sefisher/6DOF-servo/img/assetto_corsa.png

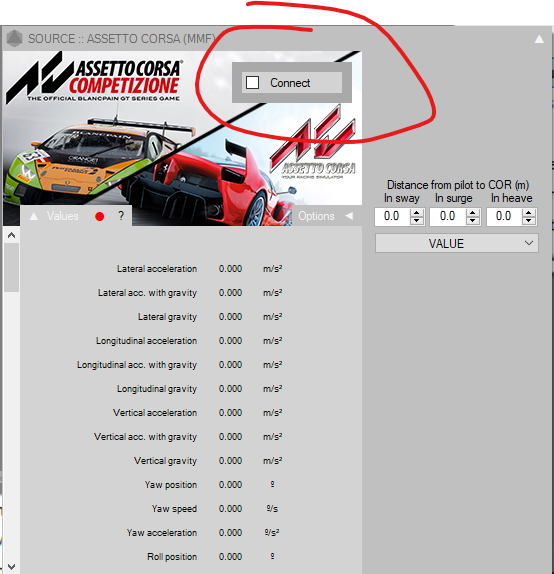
img/assetto_corsa.png
