sefisher/6DOF-servo/img/runtest-connect-source.png

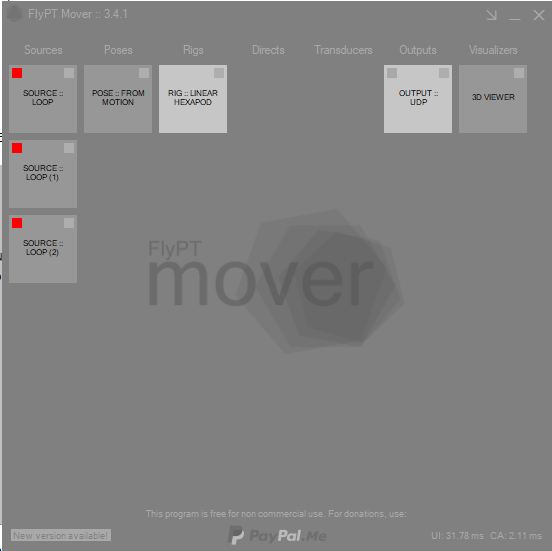
img/runtest-connect-source.png
