sefisher/6DOF-servo/other files/thingiverse desktop model stl/Actuator-Base.STL

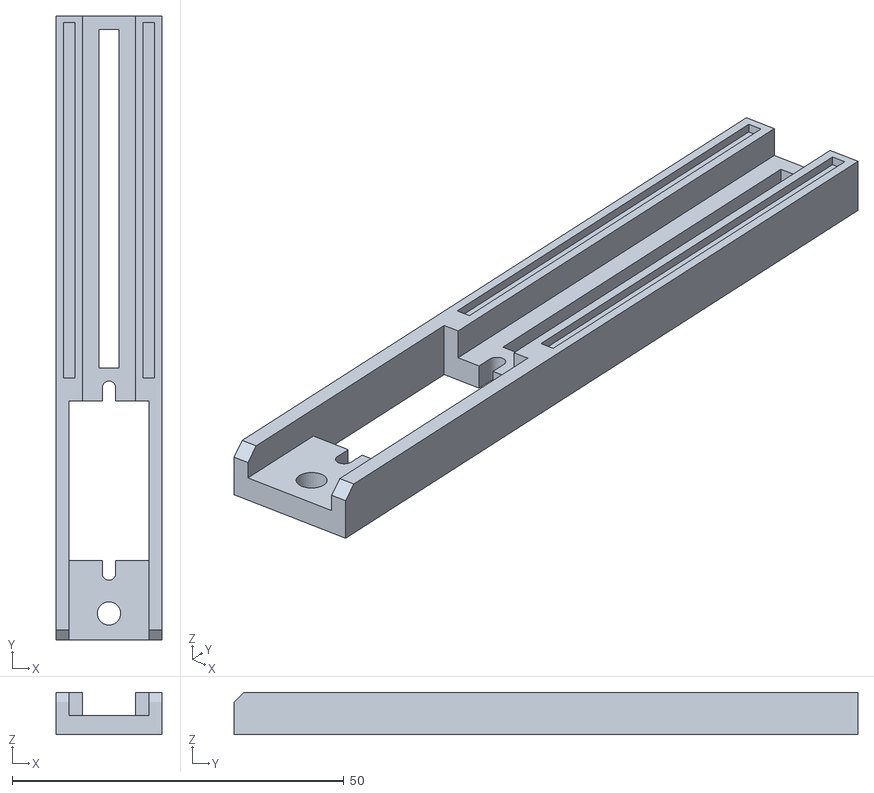
[picture p18: CAD file, 2021-08-05]
other files/thingiverse desktop model stl/Actuator-Base.STL
16.0 x 94.0 x 6.40
