sefisher/6DOF-servo/other files/thingiverse desktop model stl/Actuator-Rod.STL

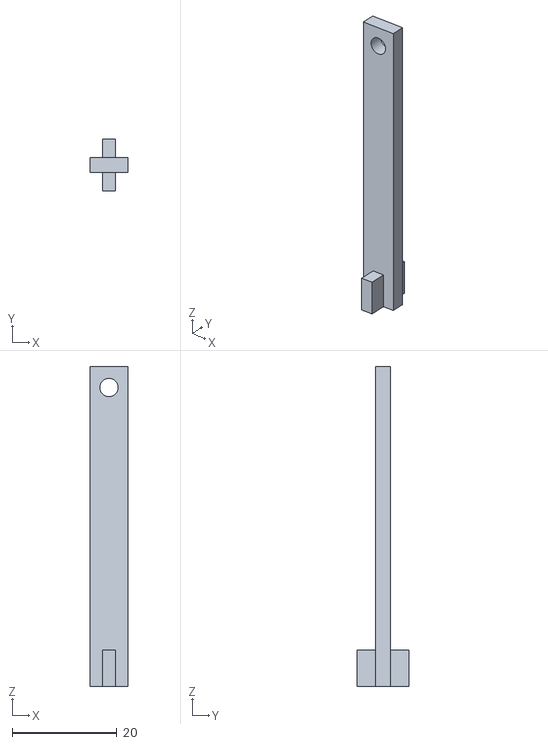
[picture p19: CAD file, 2021-08-05]
other files/thingiverse desktop model stl/Actuator-Rod.STL
7.25 x 10.0 x 61.0
