sefisher/6DOF-servo/other files/thingiverse desktop model stl/Actuator-Joint_F.STL

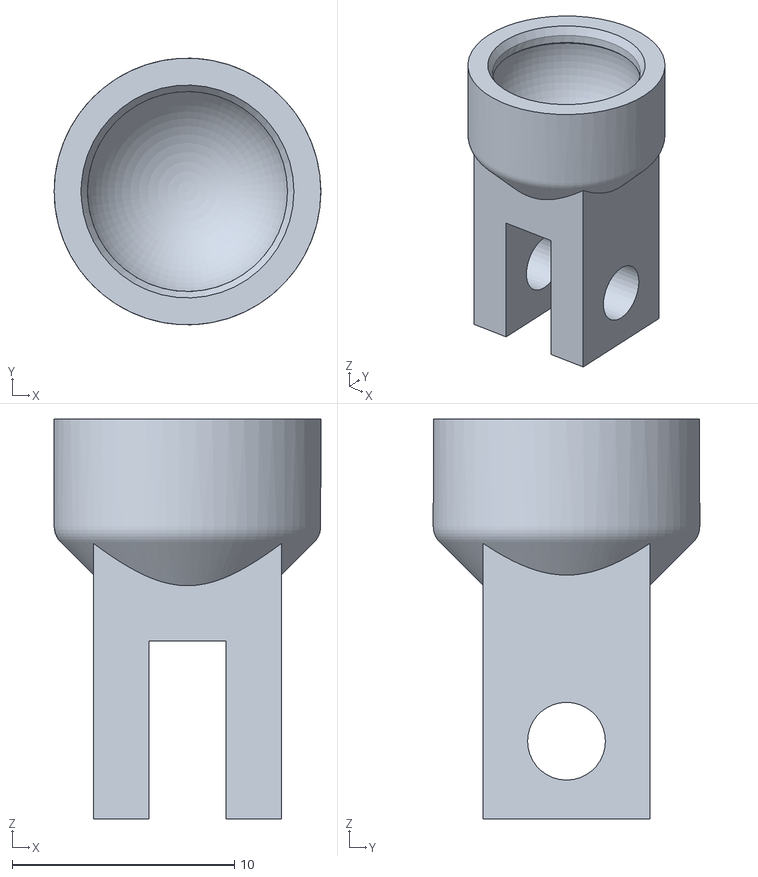
[picture p21: CAD file, 2021-08-05]
other files/thingiverse desktop model stl/Actuator-Joint_F.STL
12.0 x 12.0 x 18.0
