sefisher/6DOF-servo/other files/thingiverse desktop model stl/Base_150mm_Without_Mount.STL

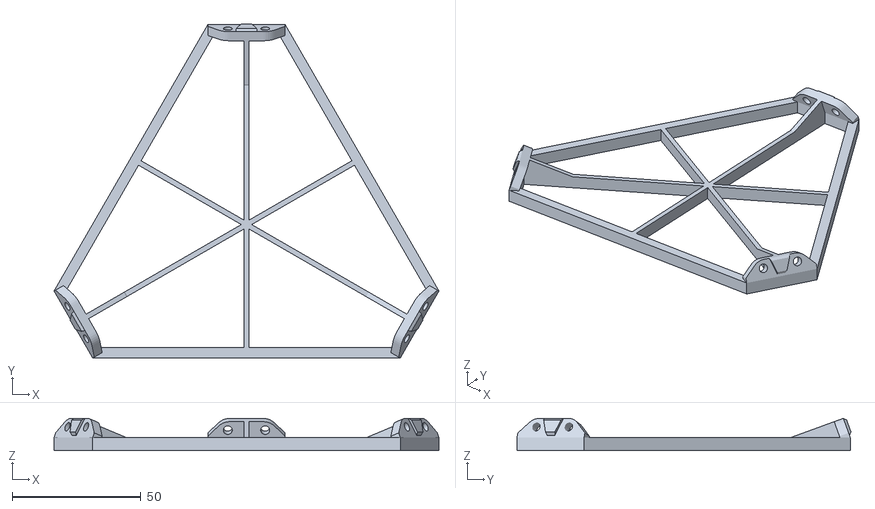
[picture p22: CAD file, 2021-08-05]
other files/thingiverse desktop model stl/Base_150mm_Without_Mount.STL
149.2 x 129.5 x 12.5
