sefisher/6DOF-servo/other files/thingiverse desktop model stl/Actuator-Retainer.STL

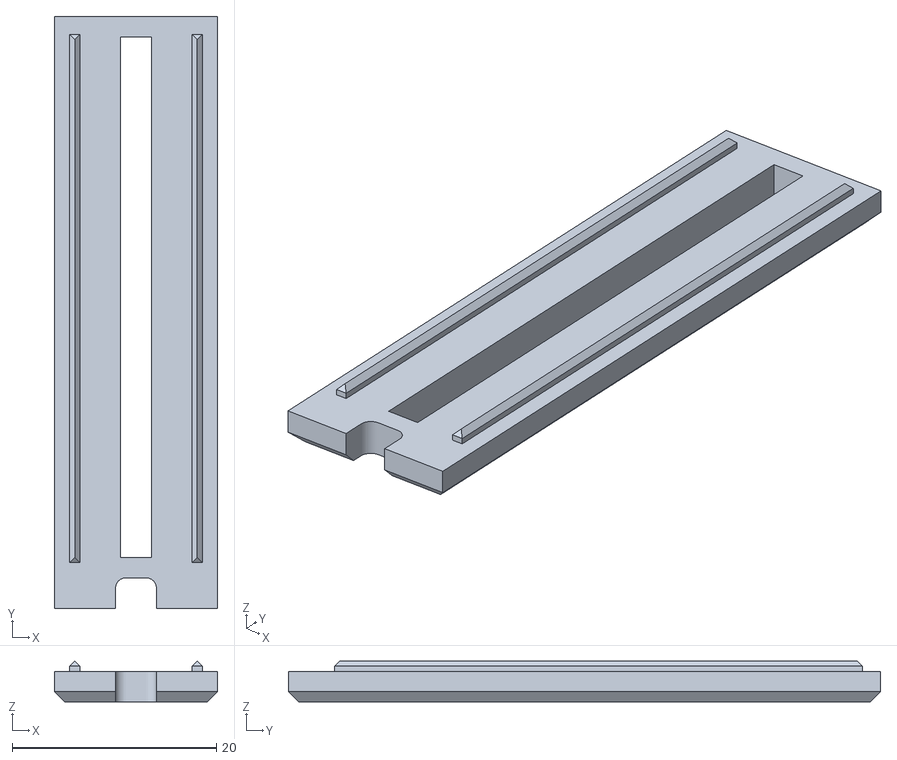
[picture p23: CAD file, 2021-08-05]
other files/thingiverse desktop model stl/Actuator-Retainer.STL
16.0 x 58.0 x 4.00
