sefisher/6DOF-servo/other files/thingiverse desktop model stl/TFT_Support_v2.STL

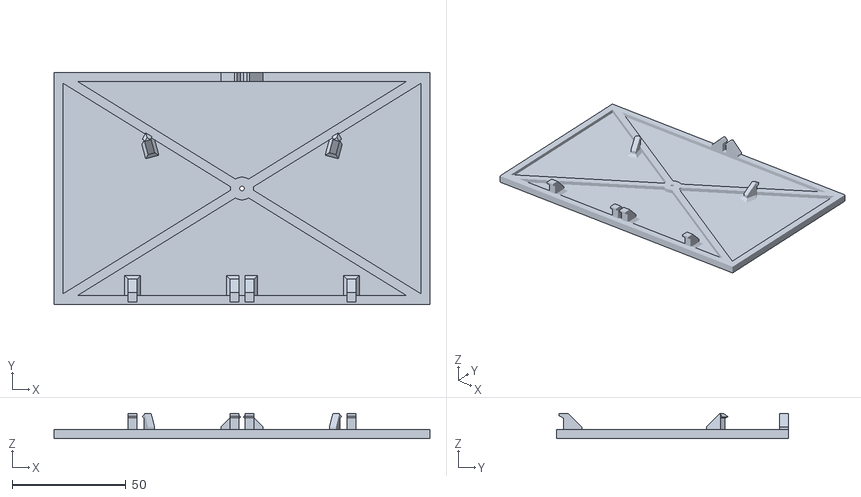
[picture p24: CAD file, 2021-08-05]
other files/thingiverse desktop model stl/TFT_Support_v2.STL
165.0 x 102.0 x 11.1
