sefisher/6DOF-servo/other files/thingiverse desktop model stl/Actuator-Joint_M.STL

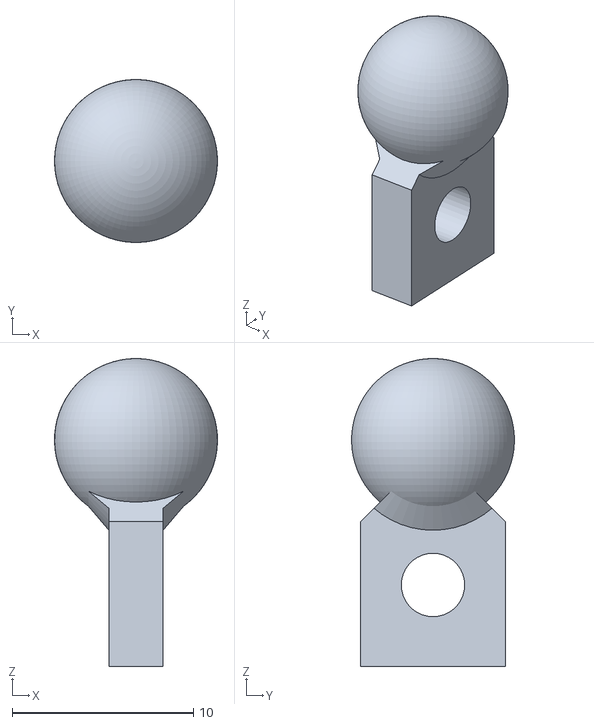
[picture p25: CAD file, 2021-08-05]
other files/thingiverse desktop model stl/Actuator-Joint_M.STL
9.00 x 8.99 x 17.0
