sefisher/6DOF-servo/other files/thingiverse desktop model stl/Bearing_Retainer_X.STL

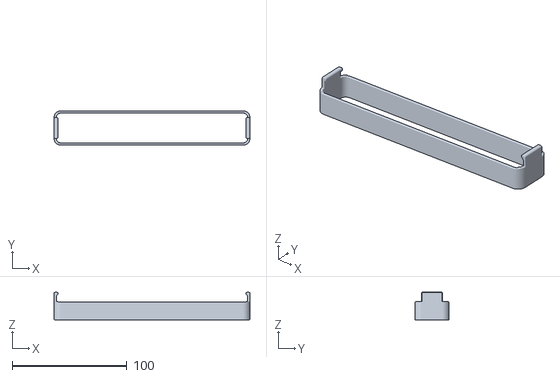
[picture p26: CAD file, 2021-08-05]
other files/thingiverse desktop model stl/Bearing_Retainer_X.STL
171.0 x 30.0 x 24.0
