sefisher/6DOF-servo/(list of files, cad)

Other CAD files:
other files/thingiverse desktop model stl/Actuator-Base-Modified.stl
