sefisher/6DOF-servo/(list of files, drawings)

Other design files:
other files/6DOF - ESP32 - PCS9685 - Layout.fzz
