sefisher/6DOF-servo/(threads)

Thread 1 (2023-12-22):

6DOF update request

HUANGJIN169, 2023-12-22:
Hello can you make a PCB circuit board controller?  Can this code and firmware support the AASD-15A servo driver?  Like the Thanos circuit board controller
